chillKB/ghoulTKL/img/pcb_top.jpg

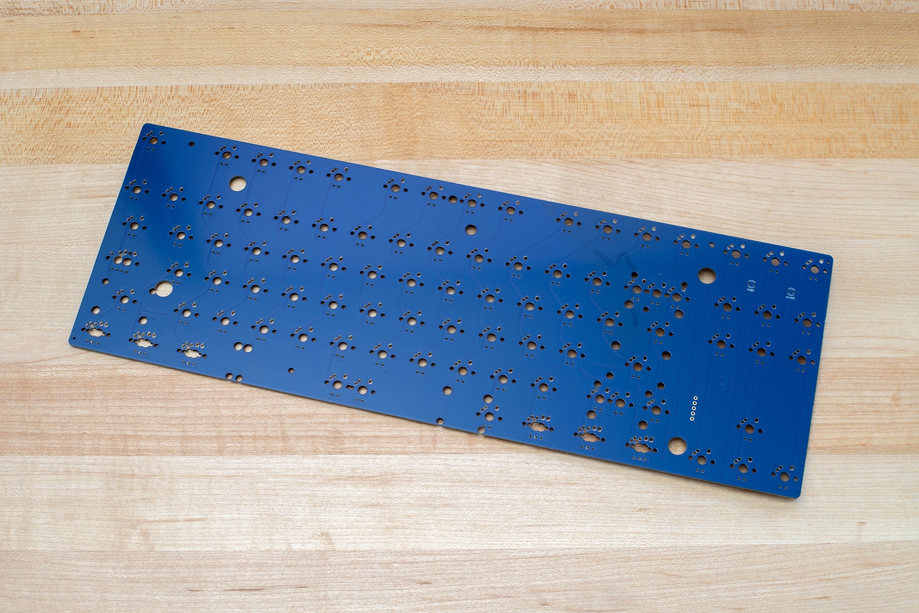
img/pcb_top.jpg
