chillKB/ghoulTKL/plate/ghoul-plate.dxf

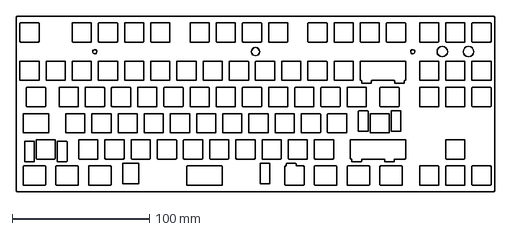
[picture p3: CAD file, 2024-12-30]
plate/ghoul-plate.dxf
348.0 x 127.5 mm
