chillKB/ghoulTKL/plate/ghoul-plate-both-enters.dxf

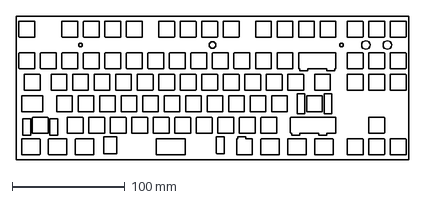
[picture p4: CAD file, 2024-12-30]
plate/ghoul-plate-both-enters.dxf
348.0 x 127.5 mm
