chillKB/ghoulTKL/ghoulTKL.kicad_sch

## KiCad design ghoulTKL.kicad_sch (2024-12-30)

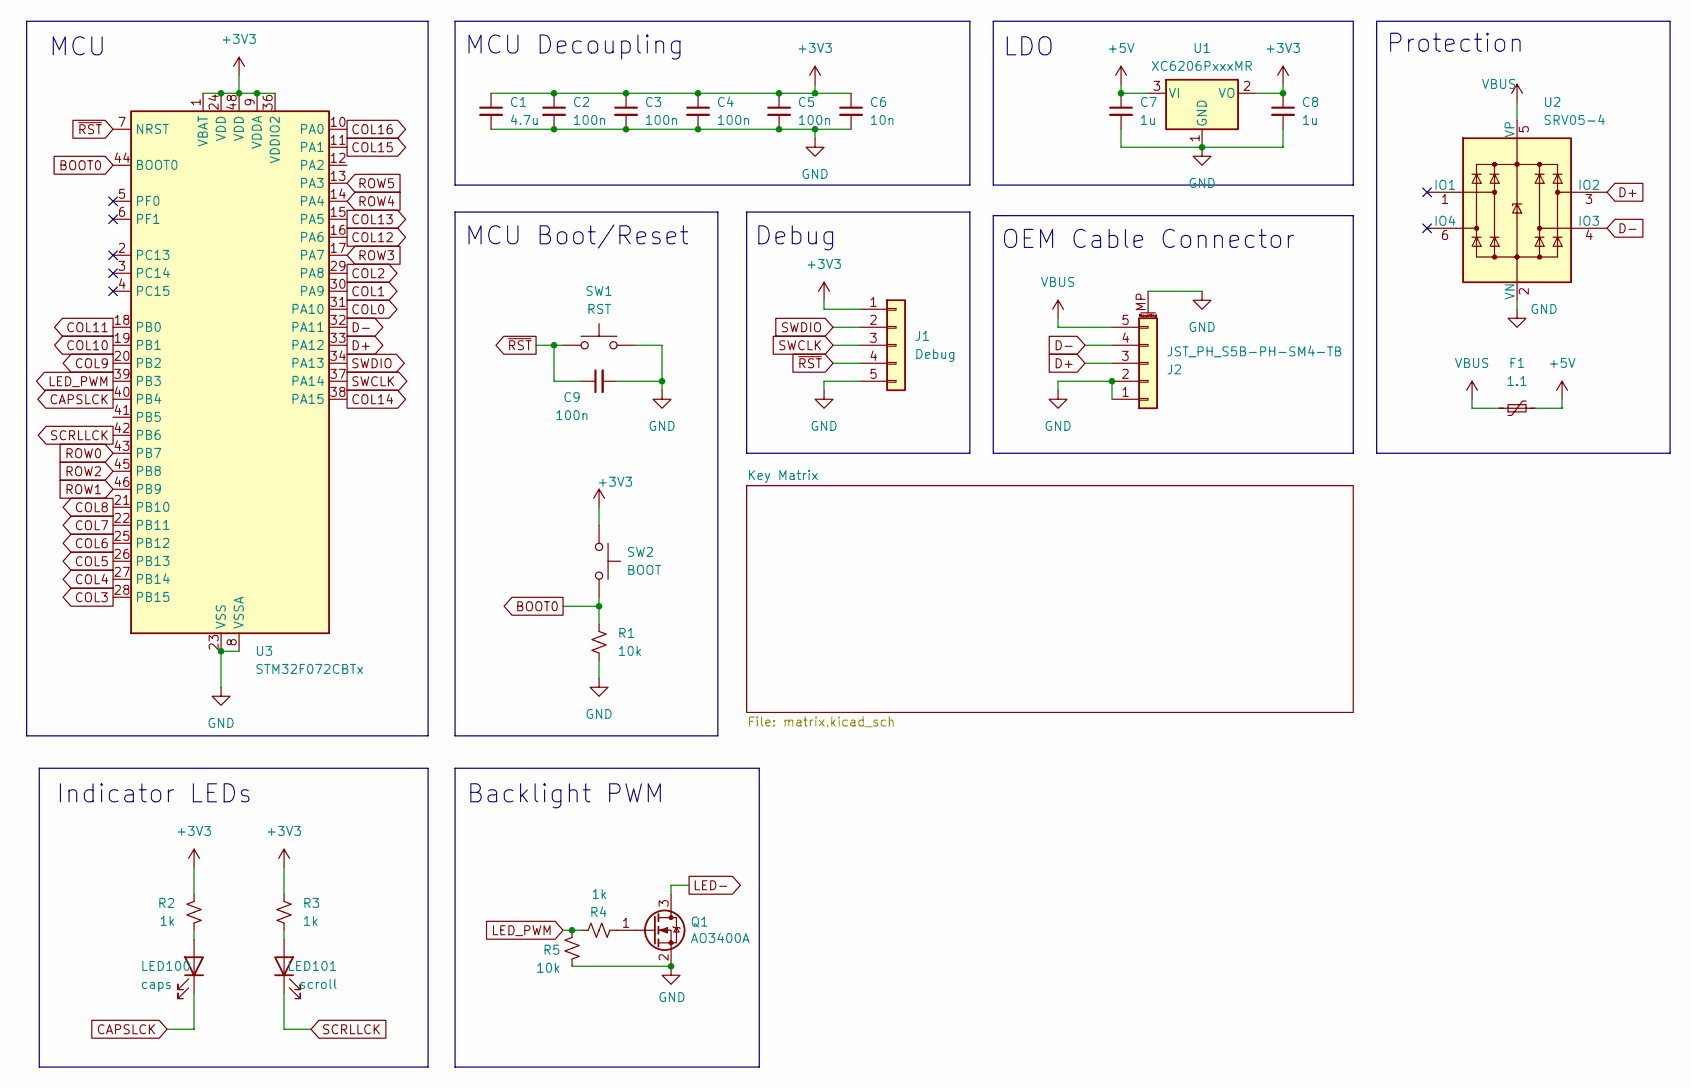
[picture p5: schematic ghoulTKL.kicad_sch]

Parts:
C1: 4.7u; C_0402_1005Metric; LCSC C23733
C2, C3, C4, C5, C9: 100n; C_0402_1005Metric; LCSC C1525
C6: 10n; C_0402_1005Metric; LCSC C15195
C7, C8: 1u; C_0402_1005Metric; LCSC C52923
F1: 1.1; Fuse_1206_3216Metric; LCSC C2760273
J1: Debug; PinHeader_1x05_P2.54mm_Vertical
J2: JST_PH_S5B-PH-SM4-TB; JST_PH_S5B-PH-SM4-TB_1x05-1MP_P2.00mm_Horizontal; LCSC C265104
LED100: caps; LED_D3.0mm
LED101: scroll; LED_D3.0mm
Q1: AO3400A; SOT-23; LCSC C20917
R1, R5: 10k; R_0603_1608Metric; LCSC C25804
R2, R3, R4: 1k; R_0603_1608Metric; LCSC C21190
SW1: RST; SW_SPST_TL3342; LCSC C318884
SW2: BOOT; SW_SPST_TL3342; LCSC C318884
U1: XC6206PxxxMR; SOT-23-3; LCSC C5446
U2: SRV05-4; SOT-23-6-routable; LCSC C85364
U3: STM32F072CBTx; LQFP-48_7x7mm_P0.5mm; LCSC C81720

Connections:
+3V3: C1.1, C2.1, C3.1, C4.1, C5.1, C6.1, C8.1, J1.1, R2.2, R3.2, SW2.1, U1.2 (VO), U3.1 (VBAT), U3.9 (VDDA), U3.24 (VDD), U3.36 (VDDIO2), U3.48 (VDD)
+5V: C7.1, F1.2, U1.3 (VI)
BOOT0: R1.1, SW2.2, U3.44 (BOOT0)
CAPSLCK: LED100.1 (K), U3.40 (PB4)
COL0: U3.31 (PA10)
COL1: U3.30 (PA9)
COL2: U3.29 (PA8)
COL3: U3.28 (PB15)
COL4: U3.27 (PB14)
COL5: U3.26 (PB13)
COL6: U3.25 (PB12)
COL7: U3.22 (PB11)
COL8: U3.21 (PB10)
COL9: U3.20 (PB2)
COL10: U3.19 (PB1)
COL11: U3.18 (PB0)
COL12: U3.16 (PA6)
COL13: U3.15 (PA5)
COL14: U3.38 (PA15)
COL15: U3.11 (PA1)
COL16: U3.10 (PA0)
D+: J2.3, U2.3 (IO2), U3.33 (PA12)
D-: J2.4, U2.4 (IO3), U3.32 (PA11)
GND: C1.2, C2.2, C3.2, C4.2, C5.2, C6.2, C7.2, C8.2, C9.2, J1.5, J2.1, J2.2, J2.MP (MountPin), Q1.2 (S), R1.2, R5.2, SW1.2, U1.1 (GND), U2.2 (VN), U3.8 (VSSA), U3.23 (VSS), U3.35 (VSS), U3.47 (VSS)
LED-: Q1.3 (D)
LED_PWM: R4.2, R5.1, U3.39 (PB3)
unnamed: LED100.2 (A), R2.1
unnamed: LED101.2 (A), R3.1
unnamed: Q1.1 (G), R4.1
ROW0: U3.43 (PB7)
ROW1: U3.46 (PB9)
ROW2: U3.45 (PB8)
ROW3: U3.17 (PA7)
ROW4: U3.14 (PA4)
ROW5: U3.13 (PA3)
SCRLLCK: LED101.1 (K), U3.42 (PB6)
SWCLK: J1.3, U3.37 (PA14)
SWDIO: J1.2, U3.34 (PA13)
VBUS: F1.1, J2.5, U2.5 (VP)
~RST: C9.1, J1.4, SW1.1, U3.7 (NRST)

Notes on the sheet:
MCU
Debug
Protection
OEM Cable Connector
LDO
MCU Boot/Reset
Backlight PWM
MCU Decoupling
Indicator LEDs
