chillKB/ghoulTKL/matrix.kicad_sch

## KiCad design matrix.kicad_sch (2024-12-30)

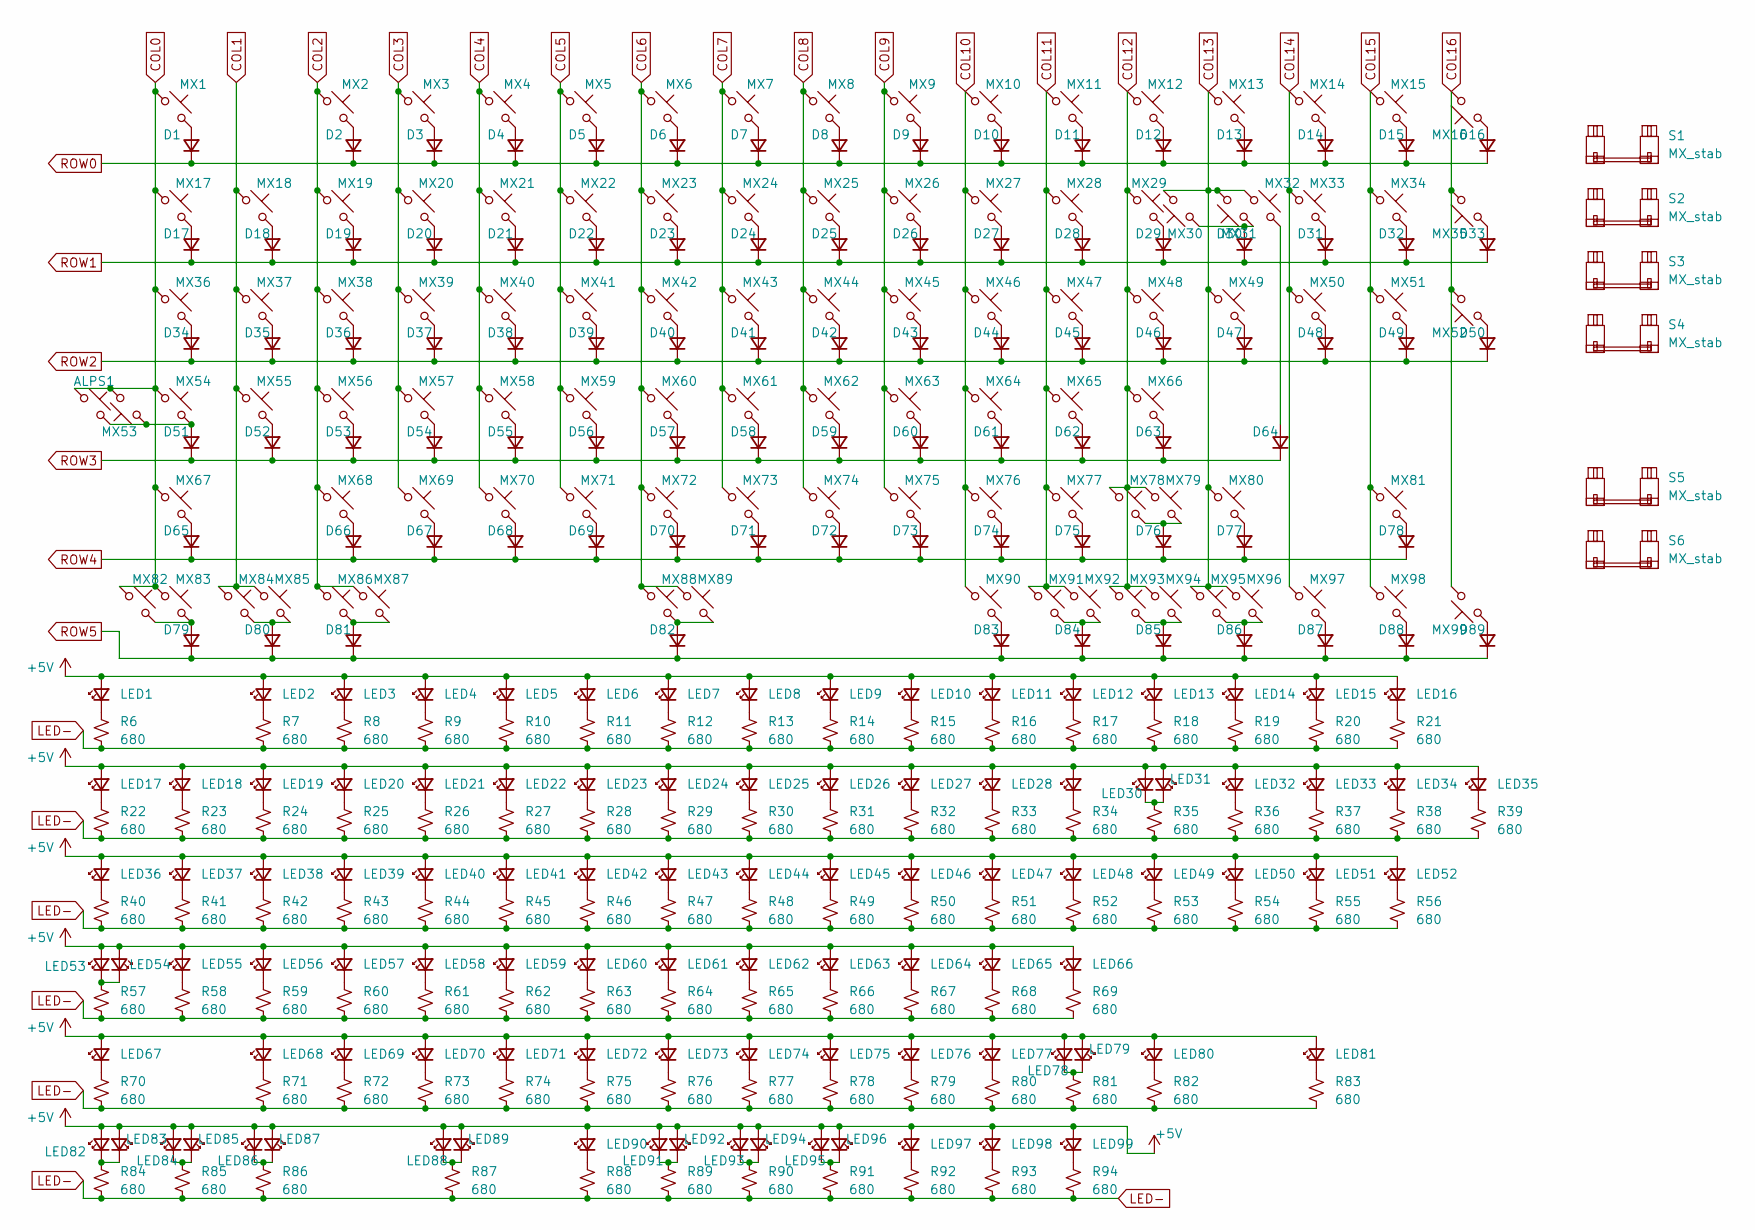
[picture p6: schematic matrix.kicad_sch]

Parts:
ALPS1: MX_SW_solder; SW_Alps_1.75u_STP_1.5
D1, D2, D3, D4, D5, D6, D7, D8, D9, D10, D11, D12, D13, D14, D15, D16, D17, D18, D19, D20, D21, D22, D23, D24, D25, D26, D27, D28, D29, D30, D31, D32, D33, D34, D35, D36, D37, D38, D39, D40, D41, D42, D43, D44, D45, D46, D47, D48, D49, D50, D51, D52, D53, D54, D55, D56, D57, D58, D59, D60, D61, D62, D63, D64, D65, D66, D67, D68, D69, D70, D71, D72, D73, D74, D75, D76, D77, D78, D79, D80, D81, D82, D83, D84, D85, D86, D87, D88, D89: D_Small; D_SOD-123; LCSC C81598
LED1, LED2, LED3, LED4, LED5, LED6, LED7, LED8, LED9, LED10, LED11, LED12, LED13, LED14, LED15, LED16, LED17, LED18, LED19, LED20, LED21, LED22, LED23, LED24, LED25, LED26, LED27, LED28, LED29, LED30, LED31, LED32, LED33, LED34, LED35, LED36, LED37, LED38, LED39, LED40, LED41, LED42, LED43, LED44, LED45, LED46, LED47, LED48, LED49, LED50, LED51, LED52, LED53, LED55, LED56, LED57, LED58, LED59, LED60, LED61, LED62, LED63, LED64, LED65, LED66, LED67, LED68, LED69, LED70, LED71, LED72, LED73, LED74, LED75, LED76, LED77, LED78, LED79, LED80, LED81, LED83, LED85, LED87, LED88, LED90, LED92, LED94, LED96, LED97, LED98, LED99: LED_Small; LED_MX_3mm
LED54, LED82, LED84, LED86, LED89, LED91, LED93, LED95: LED_Small; LED_MX_3mm-ROT
MX1, MX2, MX3, MX4, MX5, MX6, MX7, MX8, MX9, MX10, MX11, MX12, MX13, MX14, MX15, MX16, MX17, MX18, MX19, MX20, MX21, MX22, MX23, MX24, MX25, MX26, MX27, MX28, MX29, MX30, MX31, MX32, MX33, MX34, MX35, MX37, MX38, MX39, MX40, MX41, MX42, MX43, MX44, MX45, MX46, MX47, MX48, MX50, MX51, MX52, MX55, MX56, MX57, MX58, MX59, MX60, MX61, MX62, MX63, MX64, MX65, MX66, MX67, MX68, MX69, MX70, MX71, MX72, MX73, MX74, MX75, MX76, MX77, MX79, MX80, MX81, MX85, MX88, MX89, MX93, MX97, MX98, MX99: MX_SW_solder; SW_Alps_MX_1u
MX36, MX49, MX83, MX87, MX91, MX95: MX_SW_solder; SW_Alps_MX_1.5u
MX53: MX_SW_solder; SW_MX_1.75u_STP_1.25
MX54, MX78: MX_SW_solder; SW_Alps_MX_1.75u
MX82, MX84, MX86, MX90, MX92, MX94, MX96: MX_SW_solder; SW_Alps_MX_1.25u
R6, R7, R8, R9, R10, R11, R12, R13, R14, R15, R16, R17, R18, R19, R20, R21, R22, R23, R24, R25, R26, R27, R28, R29, R30, R31, R32, R33, R34, R35, R36, R37, R38, R39, R40, R41, R42, R43, R44, R45, R46, R47, R48, R49, R50, R51, R52, R53, R54, R55, R56, R57, R58, R59, R60, R61, R62, R63, R64, R65, R66, R67, R68, R69, R70, R71, R72, R73, R74, R75, R76, R77, R78, R79, R80, R81, R82, R83, R84, R85, R86, R87, R88, R89, R90, R91, R92, R93, R94: 680; R_0603_1608Metric; LCSC C23228
S1: MX_stab; STAB_MX_2u
S2, S3: MX_stab; STAB_MX_2.25u
S4: MX_stab; STAB_MX_2.75u
S5: MX_stab; STAB_MX_6.25u
S6: MX_stab; STAB_MX_7u

Connections:
+5V: LED1.2 (A), LED2.2 (A), LED3.2 (A), LED4.2 (A), LED5.2 (A), LED6.2 (A), LED7.2 (A), LED8.2 (A), LED9.2 (A), LED10.2 (A), LED11.2 (A), LED12.2 (A), LED13.2 (A), LED14.2 (A), LED15.2 (A), LED16.2 (A), LED17.2 (A), LED18.2 (A), LED19.2 (A), LED20.2 (A), LED21.2 (A), LED22.2 (A), LED23.2 (A), LED24.2 (A), LED25.2 (A), LED26.2 (A), LED27.2 (A), LED28.2 (A), LED29.2 (A), LED30.2 (A), LED31.2 (A), LED32.2 (A), LED33.2 (A), LED34.2 (A), LED35.2 (A), LED36.2 (A), LED37.2 (A), LED38.2 (A), LED39.2 (A), LED40.2 (A), LED41.2 (A), LED42.2 (A), LED43.2 (A), LED44.2 (A), LED45.2 (A), LED46.2 (A), LED47.2 (A), LED48.2 (A), LED49.2 (A), LED50.2 (A), LED51.2 (A), LED52.2 (A), LED53.2 (A), LED54.2 (A), LED55.2 (A), LED56.2 (A), LED57.2 (A), LED58.2 (A), LED59.2 (A), LED60.2 (A), LED61.2 (A), LED62.2 (A), LED63.2 (A), LED64.2 (A), LED65.2 (A), LED66.2 (A), LED67.2 (A), LED68.2 (A), LED69.2 (A), LED70.2 (A), LED71.2 (A), LED72.2 (A), LED73.2 (A), LED74.2 (A), LED75.2 (A), LED76.2 (A), LED77.2 (A), LED78.2 (A), LED79.2 (A), LED80.2 (A), LED81.2 (A), LED82.2 (A), LED83.2 (A), LED84.2 (A), LED85.2 (A), LED86.2 (A), LED87.2 (A), LED88.2 (A), LED89.2 (A), LED90.2 (A), LED91.2 (A), LED92.2 (A), LED93.2 (A), LED94.2 (A), LED95.2 (A), LED96.2 (A), LED97.2 (A), LED98.2 (A), LED99.2 (A)
COL0: ALPS1.1, MX1.1, MX17.1, MX36.1, MX53.2, MX54.1, MX67.1, MX82.1, MX83.1
COL1: MX18.1, MX37.1, MX55.1, MX84.1, MX85.1
COL2: MX2.1, MX19.1, MX38.1, MX56.1, MX68.1, MX86.1, MX87.1
COL3: MX3.1, MX20.1, MX39.1, MX57.1, MX69.1
COL4: MX4.1, MX21.1, MX40.1, MX58.1, MX70.1
COL5: MX5.1, MX22.1, MX41.1, MX59.1, MX71.1
COL6: MX6.1, MX23.1, MX42.1, MX60.1, MX72.1, MX88.1, MX89.1
COL7: MX7.1, MX24.1, MX43.1, MX61.1, MX73.1
COL8: MX8.1, MX25.1, MX44.1, MX62.1, MX74.1
COL9: MX9.1, MX26.1, MX45.1, MX63.1, MX75.1
COL10: MX10.1, MX27.1, MX46.1, MX64.1, MX76.1, MX90.1
COL11: MX11.1, MX28.1, MX47.1, MX65.1, MX77.1, MX91.1, MX92.1
COL12: MX12.1, MX29.1, MX48.1, MX66.1, MX78.1, MX79.1, MX93.1, MX94.1
COL13: MX13.1, MX30.2, MX31.2, MX32.1, MX49.1, MX80.1, MX95.1, MX96.1
COL14: MX14.1, MX33.1, MX50.1, MX97.1
COL15: MX15.1, MX34.1, MX51.1, MX81.1, MX98.1
COL16: MX16.2, MX35.2, MX52.2, MX99.2
LED-: R6.1, R7.1, R8.1, R9.1, R10.1, R11.1, R12.1, R13.1, R14.1, R15.1, R16.1, R17.1, R18.1, R19.1, R20.1, R21.1, R22.1, R23.1, R24.1, R25.1, R26.1, R27.1, R28.1, R29.1, R30.1, R31.1, R32.1, R33.1, R34.1, R35.1, R36.1, R37.1, R38.1, R39.1, R40.1, R41.1, R42.1, R43.1, R44.1, R45.1, R46.1, R47.1, R48.1, R49.1, R50.1, R51.1, R52.1, R53.1, R54.1, R55.1, R56.1, R57.1, R58.1, R59.1, R60.1, R61.1, R62.1, R63.1, R64.1, R65.1, R66.1, R67.1, R68.1, R69.1, R70.1, R71.1, R72.1, R73.1, R74.1, R75.1, R76.1, R77.1, R78.1, R79.1, R80.1, R81.1, R82.1, R83.1, R84.1, R85.1, R86.1, R87.1, R88.1, R89.1, R90.1, R91.1, R92.1, R93.1, R94.1
unnamed: ALPS1.2, D51.2 (A), MX53.1, MX54.2
unnamed: D1.2 (A), MX1.2
unnamed: D2.2 (A), MX2.2
unnamed: D3.2 (A), MX3.2
unnamed: D4.2 (A), MX4.2
unnamed: D5.2 (A), MX5.2
unnamed: D6.2 (A), MX6.2
unnamed: D7.2 (A), MX7.2
unnamed: D8.2 (A), MX8.2
unnamed: D9.2 (A), MX9.2
unnamed: D10.2 (A), MX10.2
unnamed: D11.2 (A), MX11.2
unnamed: D12.2 (A), MX12.2
unnamed: D13.2 (A), MX13.2
unnamed: D14.2 (A), MX14.2
unnamed: D15.2 (A), MX15.2
unnamed: D16.2 (A), MX16.1
unnamed: D17.2 (A), MX17.2
unnamed: D18.2 (A), MX18.2
unnamed: D19.2 (A), MX19.2
unnamed: D20.2 (A), MX20.2
unnamed: D21.2 (A), MX21.2
unnamed: D22.2 (A), MX22.2
unnamed: D23.2 (A), MX23.2
unnamed: D24.2 (A), MX24.2
unnamed: D25.2 (A), MX25.2
unnamed: D26.2 (A), MX26.2
unnamed: D27.2 (A), MX27.2
unnamed: D28.2 (A), MX28.2
unnamed: D29.2 (A), MX29.2
unnamed: D30.2 (A), MX30.1, MX31.1
unnamed: D31.2 (A), MX33.2
unnamed: D32.2 (A), MX34.2
unnamed: D33.2 (A), MX35.1
unnamed: D34.2 (A), MX36.2
unnamed: D35.2 (A), MX37.2
unnamed: D36.2 (A), MX38.2
unnamed: D37.2 (A), MX39.2
unnamed: D38.2 (A), MX40.2
unnamed: D39.2 (A), MX41.2
unnamed: D40.2 (A), MX42.2
unnamed: D41.2 (A), MX43.2
unnamed: D42.2 (A), MX44.2
unnamed: D43.2 (A), MX45.2
unnamed: D44.2 (A), MX46.2
unnamed: D45.2 (A), MX47.2
unnamed: D46.2 (A), MX48.2
unnamed: D47.2 (A), MX49.2
unnamed: D48.2 (A), MX50.2
unnamed: D49.2 (A), MX51.2
unnamed: D50.2 (A), MX52.1
unnamed: D52.2 (A), MX55.2
unnamed: D53.2 (A), MX56.2
unnamed: D54.2 (A), MX57.2
unnamed: D55.2 (A), MX58.2
unnamed: D56.2 (A), MX59.2
unnamed: D57.2 (A), MX60.2
unnamed: D58.2 (A), MX61.2
unnamed: D59.2 (A), MX62.2
unnamed: D60.2 (A), MX63.2
unnamed: D61.2 (A), MX64.2
unnamed: D62.2 (A), MX65.2
unnamed: D63.2 (A), MX66.2
unnamed: D64.2 (A), MX32.2
unnamed: D65.2 (A), MX67.2
unnamed: D66.2 (A), MX68.2
unnamed: D67.2 (A), MX69.2
unnamed: D68.2 (A), MX70.2
unnamed: D69.2 (A), MX71.2
unnamed: D70.2 (A), MX72.2
unnamed: D71.2 (A), MX73.2
unnamed: D72.2 (A), MX74.2
unnamed: D73.2 (A), MX75.2
unnamed: D74.2 (A), MX76.2
unnamed: D75.2 (A), MX77.2
unnamed: D76.2 (A), MX78.2, MX79.2
unnamed: D77.2 (A), MX80.2
unnamed: D78.2 (A), MX81.2
unnamed: D79.2 (A), MX82.2, MX83.2
unnamed: D80.2 (A), MX84.2, MX85.2
unnamed: D81.2 (A), MX86.2, MX87.2
unnamed: D82.2 (A), MX88.2, MX89.2
unnamed: D83.2 (A), MX90.2
unnamed: D84.2 (A), MX91.2, MX92.2
unnamed: D85.2 (A), MX93.2, MX94.2
unnamed: D86.2 (A), MX95.2, MX96.2
unnamed: D87.2 (A), MX97.2
unnamed: D88.2 (A), MX98.2
unnamed: D89.2 (A), MX99.1
unnamed: LED1.1 (K), R6.2
unnamed: LED2.1 (K), R7.2
unnamed: LED3.1 (K), R8.2
unnamed: LED4.1 (K), R9.2
unnamed: LED5.1 (K), R10.2
unnamed: LED6.1 (K), R11.2
unnamed: LED7.1 (K), R12.2
unnamed: LED8.1 (K), R13.2
unnamed: LED9.1 (K), R14.2
unnamed: LED10.1 (K), R15.2
unnamed: LED11.1 (K), R16.2
unnamed: LED12.1 (K), R17.2
unnamed: LED13.1 (K), R18.2
unnamed: LED14.1 (K), R19.2
unnamed: LED15.1 (K), R20.2
unnamed: LED16.1 (K), R21.2
unnamed: LED17.1 (K), R22.2
unnamed: LED18.1 (K), R23.2
unnamed: LED19.1 (K), R24.2
unnamed: LED20.1 (K), R25.2
unnamed: LED21.1 (K), R26.2
unnamed: LED22.1 (K), R27.2
unnamed: LED23.1 (K), R28.2
unnamed: LED24.1 (K), R29.2
unnamed: LED25.1 (K), R30.2
unnamed: LED26.1 (K), R31.2
unnamed: LED27.1 (K), R32.2
unnamed: LED28.1 (K), R33.2
unnamed: LED29.1 (K), R34.2
unnamed: LED30.1 (K), LED31.1 (K), R35.2
unnamed: LED32.1 (K), R36.2
unnamed: LED33.1 (K), R37.2
unnamed: LED34.1 (K), R38.2
unnamed: LED35.1 (K), R39.2
unnamed: LED36.1 (K), R40.2
unnamed: LED37.1 (K), R41.2
unnamed: LED38.1 (K), R42.2
unnamed: LED39.1 (K), R43.2
unnamed: LED40.1 (K), R44.2
unnamed: LED41.1 (K), R45.2
unnamed: LED42.1 (K), R46.2
unnamed: LED43.1 (K), R47.2
unnamed: LED44.1 (K), R48.2
unnamed: LED45.1 (K), R49.2
unnamed: LED46.1 (K), R50.2
unnamed: LED47.1 (K), R51.2
unnamed: LED48.1 (K), R52.2
unnamed: LED49.1 (K), R53.2
unnamed: LED50.1 (K), R54.2
unnamed: LED51.1 (K), R55.2
unnamed: LED52.1 (K), R56.2
unnamed: LED53.1 (K), LED54.1 (K), R57.2
unnamed: LED55.1 (K), R58.2
unnamed: LED56.1 (K), R59.2
unnamed: LED57.1 (K), R60.2
unnamed: LED58.1 (K), R61.2
unnamed: LED59.1 (K), R62.2
unnamed: LED60.1 (K), R63.2
unnamed: LED61.1 (K), R64.2
unnamed: LED62.1 (K), R65.2
unnamed: LED63.1 (K), R66.2
unnamed: LED64.1 (K), R67.2
unnamed: LED65.1 (K), R68.2
unnamed: LED66.1 (K), R69.2
unnamed: LED67.1 (K), R70.2
unnamed: LED68.1 (K), R71.2
unnamed: LED69.1 (K), R72.2
unnamed: LED70.1 (K), R73.2
unnamed: LED71.1 (K), R74.2
unnamed: LED72.1 (K), R75.2
unnamed: LED73.1 (K), R76.2
unnamed: LED74.1 (K), R77.2
unnamed: LED75.1 (K), R78.2
unnamed: LED76.1 (K), R79.2
unnamed: LED77.1 (K), R80.2
unnamed: LED78.1 (K), LED79.1 (K), R81.2
unnamed: LED80.1 (K), R82.2
unnamed: LED81.1 (K), R83.2
unnamed: LED82.1 (K), LED83.1 (K), R84.2
unnamed: LED84.1 (K), LED85.1 (K), R85.2
unnamed: LED86.1 (K), LED87.1 (K), R86.2
unnamed: LED88.1 (K), LED89.1 (K), R87.2
unnamed: LED90.1 (K), R88.2
unnamed: LED91.1 (K), LED92.1 (K), R89.2
unnamed: LED93.1 (K), LED94.1 (K), R90.2
unnamed: LED95.1 (K), LED96.1 (K), R91.2
unnamed: LED97.1 (K), R92.2
unnamed: LED98.1 (K), R93.2
unnamed: LED99.1 (K), R94.2
ROW0: D1.1 (K), D2.1 (K), D3.1 (K), D4.1 (K), D5.1 (K), D6.1 (K), D7.1 (K), D8.1 (K), D9.1 (K), D10.1 (K), D11.1 (K), D12.1 (K), D13.1 (K), D14.1 (K), D15.1 (K), D16.1 (K)
ROW1: D17.1 (K), D18.1 (K), D19.1 (K), D20.1 (K), D21.1 (K), D22.1 (K), D23.1 (K), D24.1 (K), D25.1 (K), D26.1 (K), D27.1 (K), D28.1 (K), D29.1 (K), D30.1 (K), D31.1 (K), D32.1 (K), D33.1 (K)
ROW2: D34.1 (K), D35.1 (K), D36.1 (K), D37.1 (K), D38.1 (K), D39.1 (K), D40.1 (K), D41.1 (K), D42.1 (K), D43.1 (K), D44.1 (K), D45.1 (K), D46.1 (K), D47.1 (K), D48.1 (K), D49.1 (K), D50.1 (K)
ROW3: D51.1 (K), D52.1 (K), D53.1 (K), D54.1 (K), D55.1 (K), D56.1 (K), D57.1 (K), D58.1 (K), D59.1 (K), D60.1 (K), D61.1 (K), D62.1 (K), D63.1 (K), D64.1 (K)
ROW4: D65.1 (K), D66.1 (K), D67.1 (K), D68.1 (K), D69.1 (K), D70.1 (K), D71.1 (K), D72.1 (K), D73.1 (K), D74.1 (K), D75.1 (K), D76.1 (K), D77.1 (K), D78.1 (K)
ROW5: D79.1 (K), D80.1 (K), D81.1 (K), D82.1 (K), D83.1 (K), D84.1 (K), D85.1 (K), D86.1 (K), D87.1 (K), D88.1 (K), D89.1 (K)
